rich2025/Personal-Alert-Device/Previous_Reports.md

# Previous Project Reports
This file contains a list of all the reports we submitted over the course of our senior design semesters. The reports include testing, customer installation, the user manual, and test plans that highlighted specific features of our device we tested during project checkups. 

## Files
- [Prototype Test Report](./PDFs/Prototype_Test_Report.docx.pdf)
- [Prototype Test Plan](./PDFs/Prototype_Test_Plan.docx.pdf)
- [Second Prototype Test Report](./Second_Prototype_Test_Report.docx.pdf)
- [Second Prototype Test Plan](./PDFs/Second_Prototype_Test_Plan.docx.pdf)
- [Final Test Report](./PDFs/Final_Test_Report.docx.pdf)
- [Final Test Plan](./PDFs/Final_Test_Plan.docx.pdf)
- [User Manual](./PDFs/PAD_User_Manual.docx.pdf)
- [Customer Installation](./PDFs/Team_19_Customer_Installation_Report.docx.pdf)
