rich2025/Personal-Alert-Device/app/src/main/ic_launcher-playstore.png

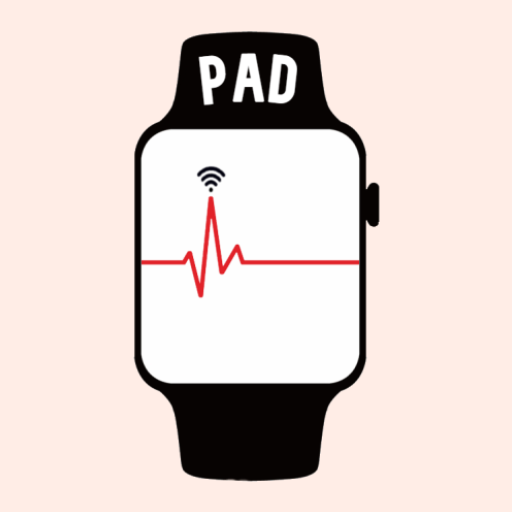
app/src/main/ic_launcher-playstore.png
