rich2025/Personal-Alert-Device/images/pcb1.png

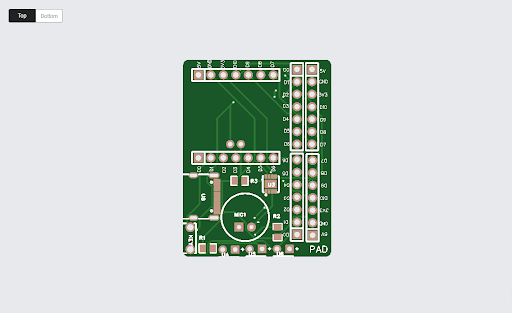
images/pcb1.png
