rich2025/Personal-Alert-Device/images/transmitter.jpg

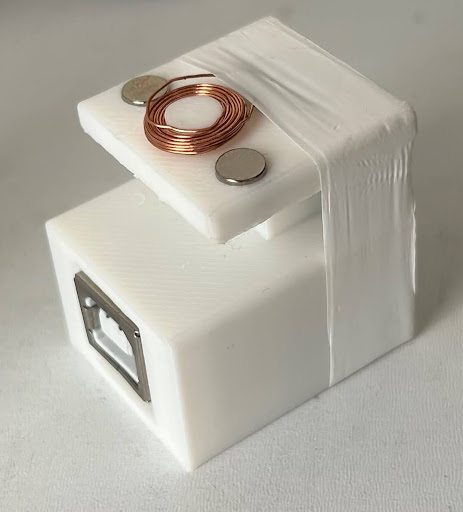
images/transmitter.jpg
