rich2025/Personal-Alert-Device/PDFs/Body_Drawing.pdf

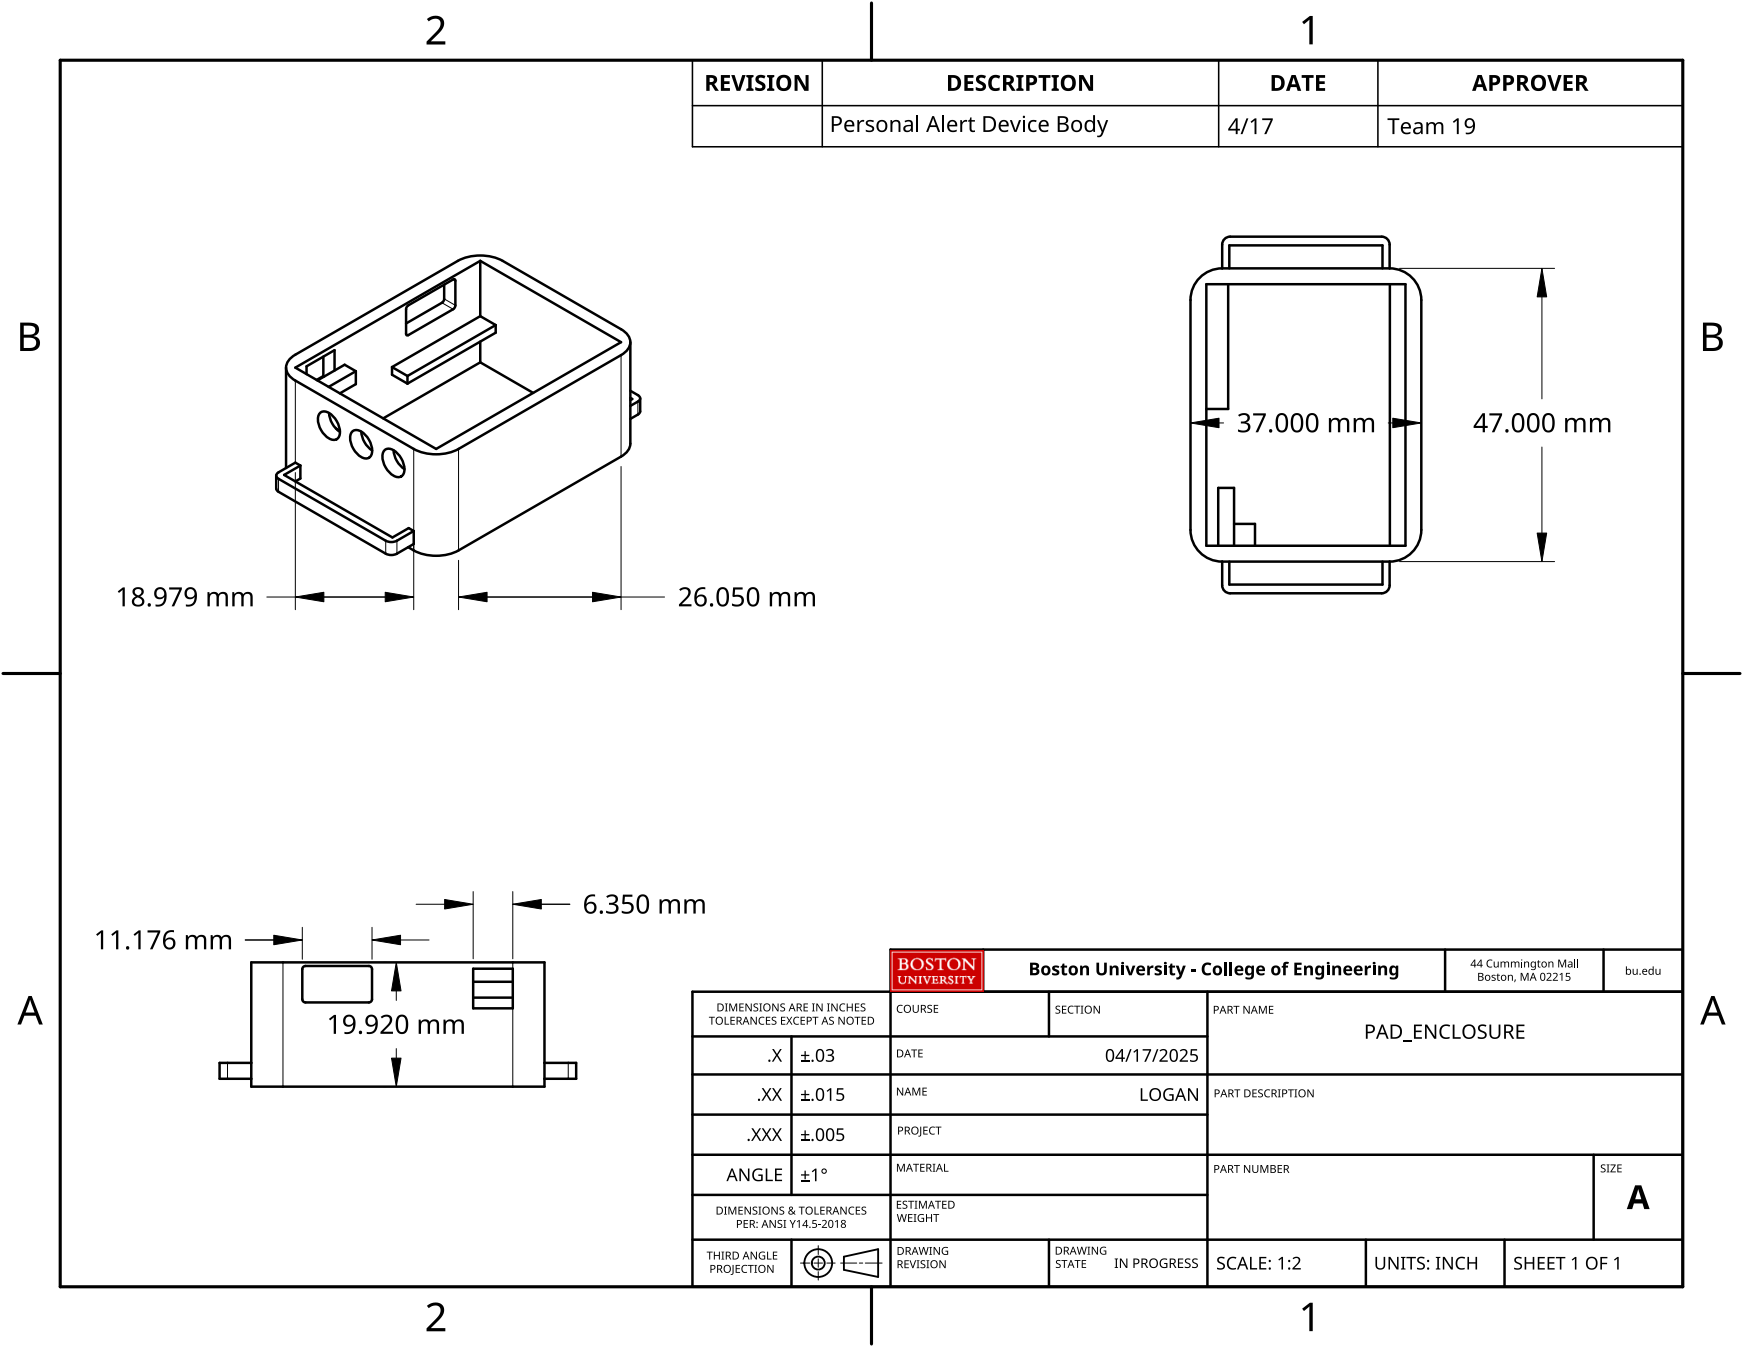
[picture p42: page 1]
