rich2025/Personal-Alert-Device/PDFs/Bottom_Drawing.pdf

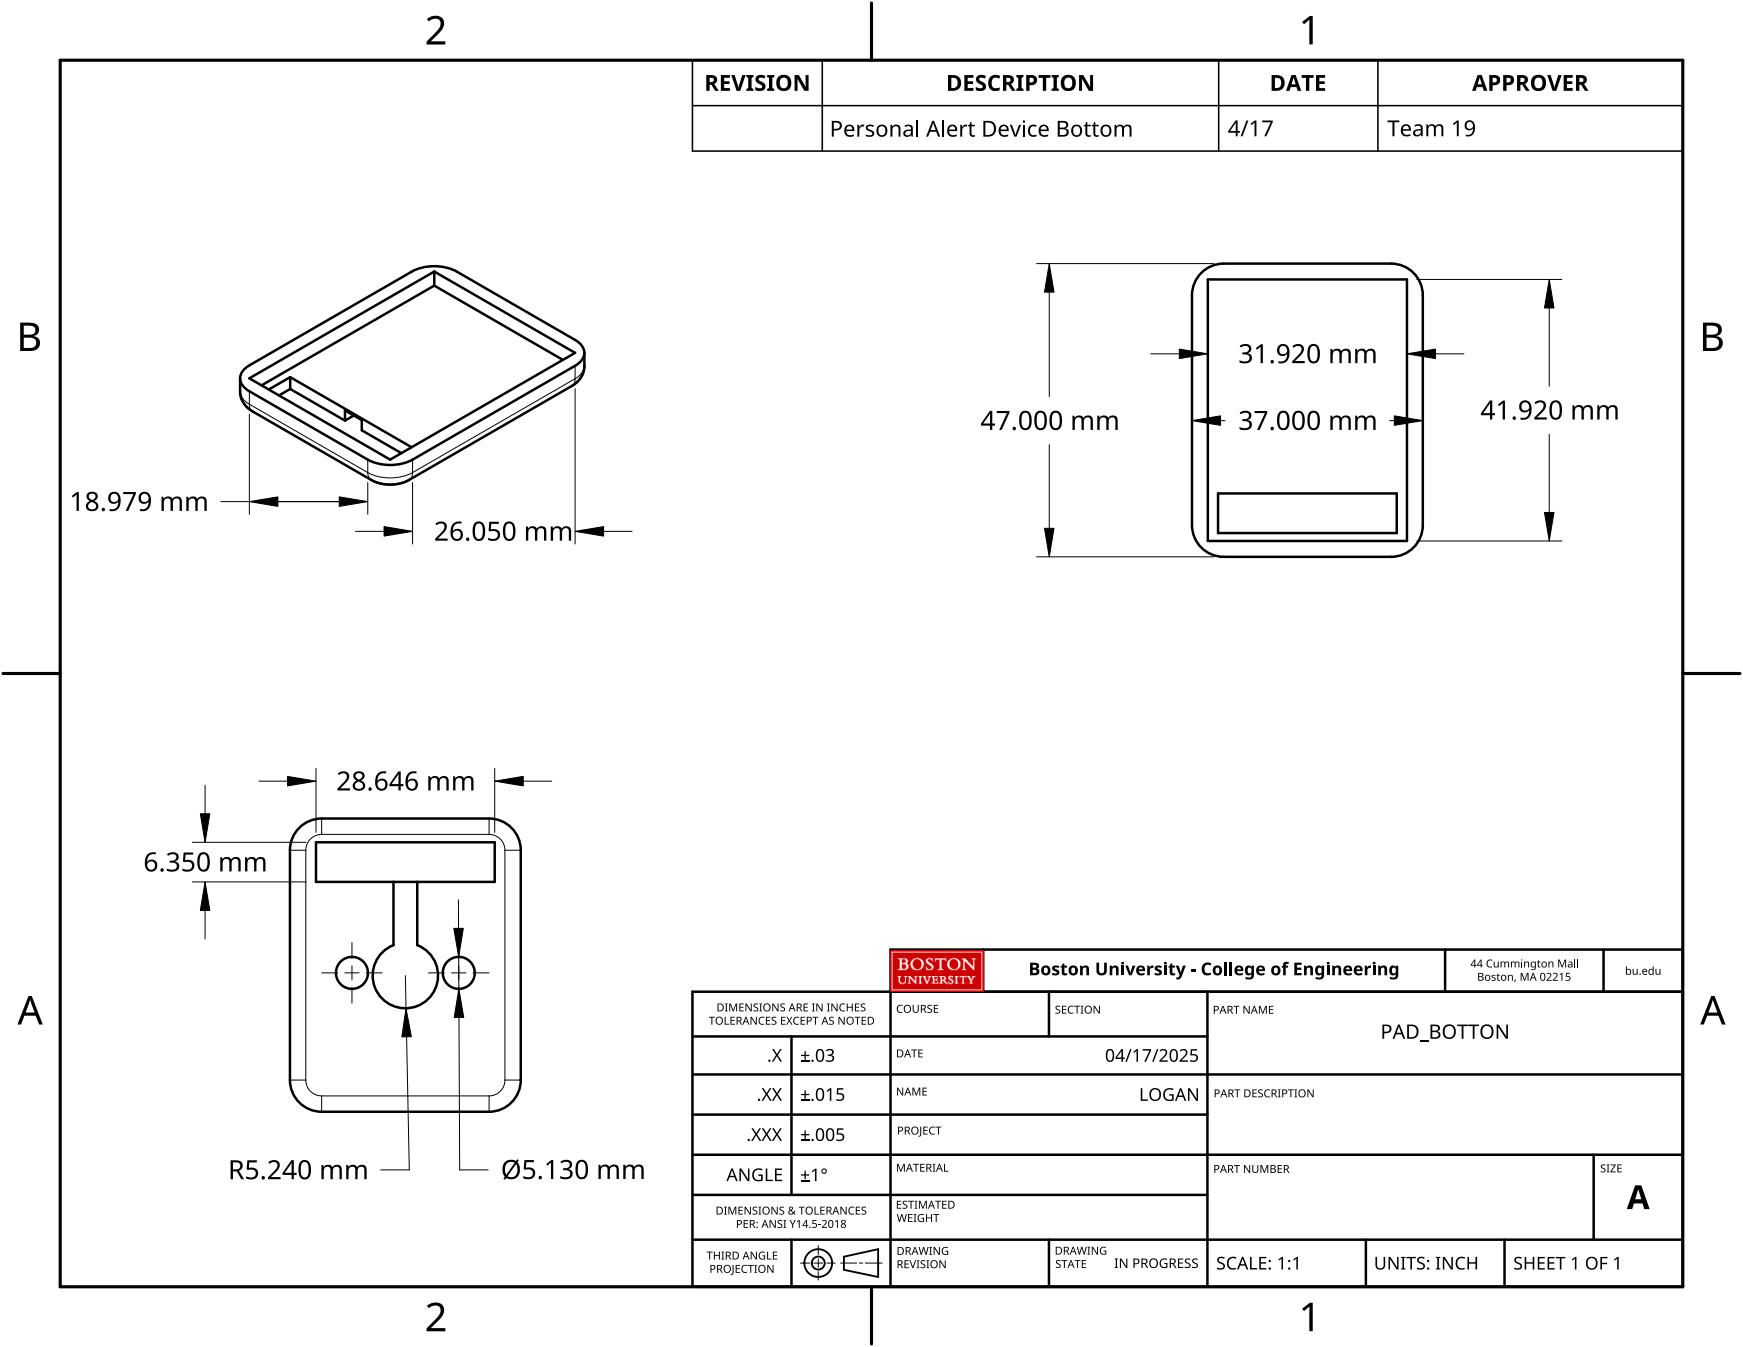
[picture p43: page 1]
