rich2025/Personal-Alert-Device/PDFs/Charging-Stand_Drawing.pdf

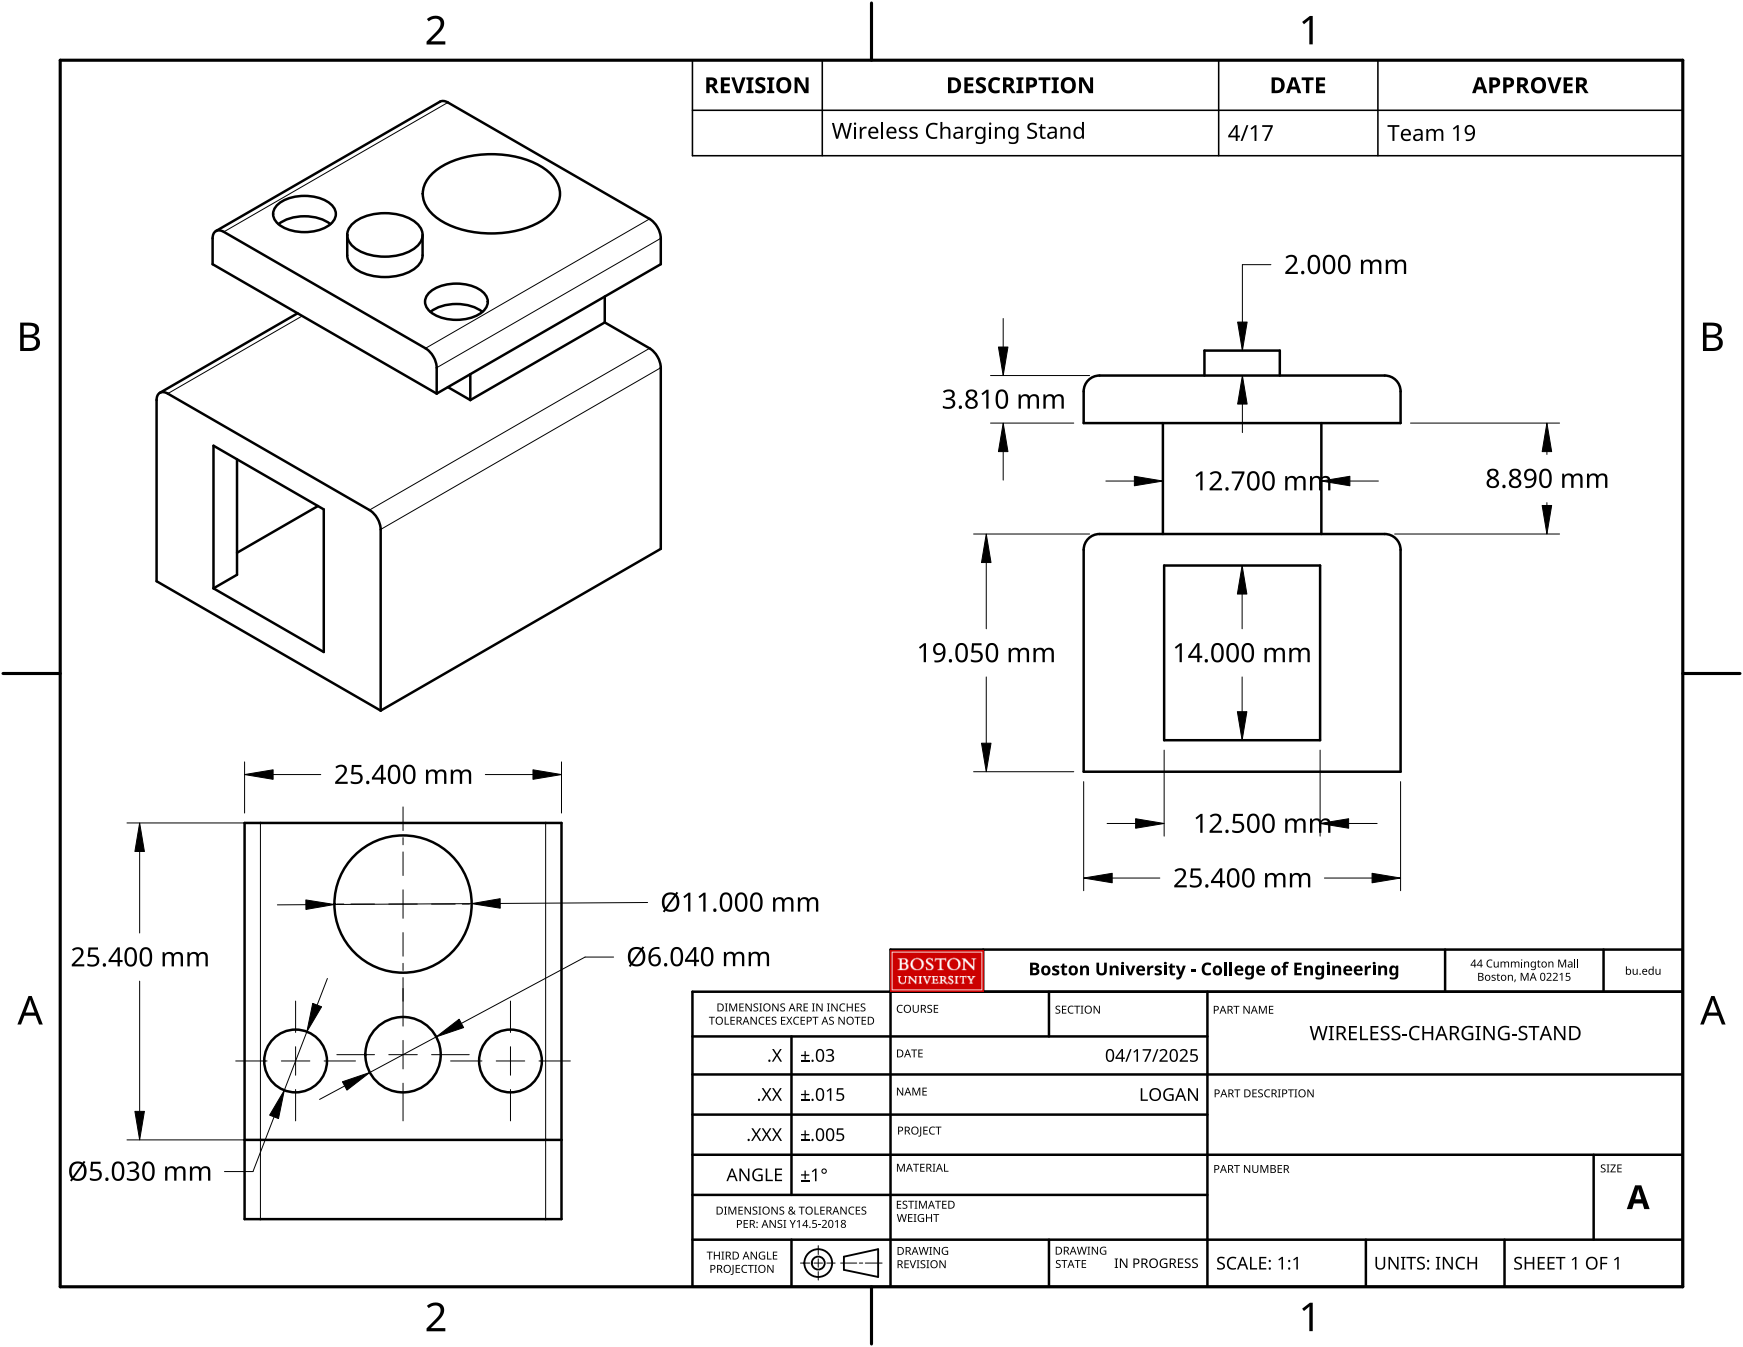
[picture p44: page 1]
