rich2025/Personal-Alert-Device/(commit log)

2024-10-22 Main screen added navigation buttons
2024-10-24 MainScreen - added color to buttons, adjusted sizing, added hold for help button
2024-10-24 Add more screens and update help button functionality
2024-10-28 Added image icons to corresponding buttons on MainScreen
2024-11-04 Added back button for return navigation on contacts list screen
2024-11-05 Added back button to main contacts screen, changed colors, testing contacts list scrolling
2024-11-05 Encounted error with return button overlaying the permissions button and text, had to remove
2024-11-06 Added back button to permissions and contact list screen
2024-11-06 Updated add designated contacts button in contacts screen
2024-11-10 Added Sign In functionality using Firebase and Google Cloud features. New Files include, GoogleAuthUiClient.kt, SignInScreen.kt, SignInState.kt, and SignInViewModel.kt. The main changes that were mad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
2024-11-14 Added return button on all screens
2024-11-18 Added logic for the sign out button, Put it in the top left but we can change that if we don't like it.
2024-12-03 Add Vitals and History navigation buttons on Health screen, need to create new screens
2025-02-05 Added shared view model to upload profile picture, download profile picture, and persist across refresh. fixed camera function by adding permission in manifest
2025-02-09 Updated firestore field names, uploaded return buttons
2025-02-20 Auto calculate age using java calendar, setAge. Fix save button with new launchedeffect
2025-03-22 GET vital sensor data from Adafruit IO and upload to Firestore
2025-03-25 Added 24 hr avg and hi/lo logic (only for temperature right now). minor changes. added fetch connection status and store in Firestore
2025-03-25 added temp buttons and return
2025-03-29 added connection status displayed around device button
2025-03-29 add return button to history screen
2025-03-29 added medical info button, route from profile info screen for future also
2025-04-06 added averages for heart rate and blood oxygen sensors
2025-04-07 Implement device (howto) screen and update UI for vitalsscreen
2025-04-07 medical info screen return button update
2025-04-07 main acitivty update for fetching battery feed from adafruit
2025-04-07 battery percentage calculate off voltage fix
2025-04-08 added manual button activitation and fall detection emergency response from adafruit io, emergency record, webhook for sms
2025-04-24 Update README_HARDWARE.md
    Schematics and other files uploaded
2025-04-25 speech recognition library for arduino
2025-04-25 personal alert device arduino
2025-04-26 Rename Prototype Test Plan.docx.pdf to Prototype_Test_Plan.docx.pdf
2025-04-26 Rename Second Prototype Test Plan.docx.pdf to Second_Prototype_Test_Plan.docx.pdf
2025-04-27 Rename Add a little bit of body text.png to Power_system.png
2025-04-27 Rename Screenshot 2025-04-25 123643.png to PCB_WD.png
2025-04-27 Rename Screenshot 2025-03-27 231332.png to PCB_3d.png
2025-04-28 bottom of enclosure and transmitter
